SeeedDocument/Wio_GPS_Board/gps_tracker.md

---
title: GPS Tracker
category: Arduino
bzurl:
oldwikiname:
prodimagename: 
surveyurl:
sku:
---



What is GPS Tracker? GPS Tracker is an Arduino compatible development board that helps you to track any moving things on the planet. By integrating GSM&GPRS as well as GPS&BeiDou in one board, it provides an all-in-one solution for your out-door IoT project.

If you are following the latest news about Low-Power Wide-Area Network(LPWAN), you may know that 2016 is a special year because there are new technology like LoRa and Sigfox came out, which remarkably pushed the development of WAN. The GPS Tracker has similarities as LoRa and Sigfox but also quite different. It is more suitable for out-door moving tracking and situations that has high frequency customer interaction and medium volume of data, for example sharing bicycle, logistics location, pet tracking.

Comparing to traditional GPS tracking solution, Seeed’s GPS Tracker is much more easier to use and customize for the fast changing IOT market. As a user-friendly Grove development board, the look of GPS tracker may remind you of Wio Link, another started product of Seeed. So you can also find 6 grove connector on the board. As an Arduino compatible board, users can use the GPS Tracker with Arduino IDE directly.

Why do we call the GPS tracker a solution, because it is really not just a board. At SeeedStudio, we have the ability to help customer customize the GPS tracker for their own project and finish the project all the way to mass production. As GPS tracker uses standard module that is mass production, we are ready to mass production even when customer is at their prototyping stage.

We have prepared everything, the last thing we need is your creative projects, so if you are making an out-door IOT tracking project, please don’t hesitate to use the GPS Tracker!

## Features

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

### Quectel MC20 Module

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

!!!Warning
    Unlike most Arduino & Genuino boards, the GPS Tracker runs at 3.3V. The maximum voltage that the I/O pins can tolerate is 3.3V. Applying voltages higher than 3.3V to any I/O pin could damage the board.

## Specification

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

## Application Ideas

* Intelligent Transportation
* Pet Tracker
* Outdoor sports equipments
* Driving recorder
* Wearable device
* Property Security

!!!Tip
    Use Grove modules to expand your application

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

##Hardware Overview





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

## Pin Map

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

!!!Note
    All pins can act as Digital Input and Output

## Getting Started - Arduino IDE

!!!Note
    This chapter is based on Win10 and Arduino IDE v1.6.0

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

### Install the Driver (For Windows)

When the first time to insert the board, you should get a USB COM device name GPS Tracker that need to install a driver. Click [here](https://github.com/SeeedDocument/Seeeduino_LoRa/raw/master/res/driver.zip) to download driver for the board.

To make sure the driver was installed successful, open your Device Manager to see if **GPS Tracker** exists.

### Install the library of GPS Tracker(For Windows, Linux and Mac)

Click [here](https://github.com/lanselambor/MC20_GPS_Tracker/archive/master.zip) to download the library(zip file) of GPS Tracker and import the zip library into your Arduino IDE. If you are new to this, please click [here](https://www.arduino.cc/en/Guide/Libraries#toc4) for more information.

### Blink

Different from other boards, there is an User LED SK6812 on GPS Tracker, which is an intelligent control LED light source and similar to ws2812b. Now we are going to upload our first demo - Blink to GPS Tracker, which will introduce how to use the User LED.

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

```c
#include "MC20_Arduino_Interface.h"
#include <Adafruit_NeoPixel.h>

#define RGBPIN       10
#define LED_NUM      1

Adafruit_NeoPixel pixels = Adafruit_NeoPixel(LED_NUM, RGBPIN, NEO_GRB + NEO_KHZ800);

void setup() {

  pixels.begin(); // This initializes the NeoPixel library.
}

void loop() {

  // For a set of NeoPixels the first NeoPixel is 0, second is 1, all the way up to the count of pixels minus one.
  // pixels.Color takes RGB values, from 0,0,0 up to 255,255,255
  pixels.setPixelColor(0, pixels.Color(0,0,100)); // Moderately bright blue color.
  pixels.show(); // This sends the updated pixel color to the hardware.
  delay(1000);   // Wait for 1 second
  pixels.setPixelColor(0, pixels.Color(0,0,0));   // Turn off the led.
  pixels.show(); 
  delay(1000); 
}
```

And Then,

* Click on **Tools > Board > GPS Tracker**
* Click on **Tools > Port** to select a right port number. (*Don't choose COM1*)

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

### Check battery

GPS Tracker is designed for tracking moving things outdoor. So you can power the board via a 3.7V Lipo battery with JST1.0 connector and check the voltage of your battery easily.

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

```c
#include "MC20_Arduino_Interface.h"

const int pin_battery_voltage = A4;

void setup() {
    SerialUSB.begin(115200);
}

void loop() {

    int a = analogRead(pin_battery_voltage);
    float v = a/1023.0*3.3*2.0;        // there's an 10M and 10M resistor divider
    SerialUSB.print("The voltage of battery is ");
    SerialUSB.print(v, 2);
    SerialUSB.println(" V");
    delay(1000);
}
```

### Use Grove modules to expand your application

To use 6 Grove connectors on GPS Tracker, we have to use `digitalWrite(12, HIGH)` to open 3V3\_B to power the Grove modules(D12 defaults to LOW in order to reduce consumption).

The following code shows how to use Analog and Digital Grove modules:

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

```c
#include "MC20_Arduino_Interface.h"

#define GrovePowerPin   12
#define LightSensorPin  A0
#define ButtonPin       2

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

void loop() {
    // print analog data when the button is pressed
    if (digitalRead(ButtonPin)) {
        SerialUSB.print("The value of light sensor:");
        SerialUSB.println(analogRead(LightSensorPin));
    }
    delay(500);
}   
```

### GNSS

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

And we have installed a well written library for the GPS Tracker, for simple applications you even don't need to know much about how to use the AT commands, which is complex and hard to read.

The following example shows how to read longitude and latitude and print them out in Serial Monitor. Please note that GPS Tracker should be placed outdoor to get GPS signal.

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

```c
#include "MC20_Common.h"
#include "MC20_Arduino_Interface.h"
#include "MC20_GNSS.h"

GNSS gnss = GNSS();

void setup() {
  SerialUSB.begin(115200);
  // while(!SerialUSB);

  gnss.Power_On();
  SerialUSB.println("\n\rPower On!");

  while(!gnss.open_GNSS()){
    delay(1000);
  }

  SerialUSB.println("Open GNSS OK.");
}

void loop() {
  // gnss.dataFlowMode();
  
  if(gnss.getCoordinate()){
    SerialUSB.print("GNSS: ");
    SerialUSB.print(gnss.longitude, 6); 
    SerialUSB.print(",");
    SerialUSB.println(gnss.latitude, 6);  
  } else{
    SerialUSB.println("Error!");
  }
  
  delay(1000);
}
```

### SMS Message Read

The following example shows how to read sms messages on GPS Tracker. Nano SIM card is needed in this example.

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

 ```c
#include "MC20_Common.h"
#include "MC20_Arduino_Interface.h"

#define RGBPIN 10

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

GPSTracker gpsTracker = GPSTracker();

void setup() {
  // MC20_init();
  pinMode(RGBPIN, OUTPUT);
  digitalWrite(RGBPIN, LOW);
  SerialUSB.begin(115200);
  // while(!SerialUSB);

  gpsTracker.Power_On();
  SerialUSB.println("Power On!");

  // gpsTracker.deleteSMS(1);

}

void loop() {

  if(MC20_check_readable()){
    inComing = 1;
  }else{
    delay(1000);
  }

  if(1 == inComing){
    MC20_read_buffer(buffer, 64);
    SerialUSB.println(buffer);

    if(NULL != (s = strstr(buffer,"+CMTI: \"SM\""))) { //SMS: $$+CMTI: "SM",24$$
        char message[128];
        int messageIndex = atoi(s+12);
        gpsTracker.readSMS(messageIndex, message,128);
        SerialUSB.print("Recv SMS: ");
        SerialUSB.println(message);
     }
     MC20_clean_buffer(buffer,64);  
     inComing = 0;
  }
  
}
 ```

### Bluetooth Connection

It is also very easy to connect to your Bluetooth device on GPS Tracker. Open your Arduino IDE and click on **File > Examples > MC20\_GPS\_Traker > MC20\_BlueTooth > BT\_FastConnect** to open the sketch or copy the blow code.

Then change the deviceName of your Bluetooth device, GPS Tracker will connect it automatically.

```c
#include "MC20_Common.h"
#include "MC20_BT.h"

// GPSTracker gpsTracker = GPSTracker();
BlueTooth bt = BlueTooth();
int bt_state = -1;
char *deviceName = "N-612";

void setup() {
  SerialUSB.begin(115200);
  while(!SerialUSB);

  bt.Power_On();
  SerialUSB.println("\n\rMC20 power On!");
  bt.BTPowerOn();
  SerialUSB.println("\n\rBT power On!");

  while(IDLE != (bt_state = bt.getBTState())){
    SerialUSB.print("State: ");
    SerialUSB.println(bt_state);
    delay(1000);
  }

  bt.BTFastConnect(deviceName, HFG_PROFILE);
}

void loop() {
  /* Debug */
  if(SerialUSB.available()){
    serialMC20.write(SerialUSB.read());
  }
  if(serialMC20.available()){     
    SerialUSB.write(serialMC20.read()); 
  }
}
```

## Resources

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
