SeeedDocument/Wio_GPS_Board/images/insertsim.jpg

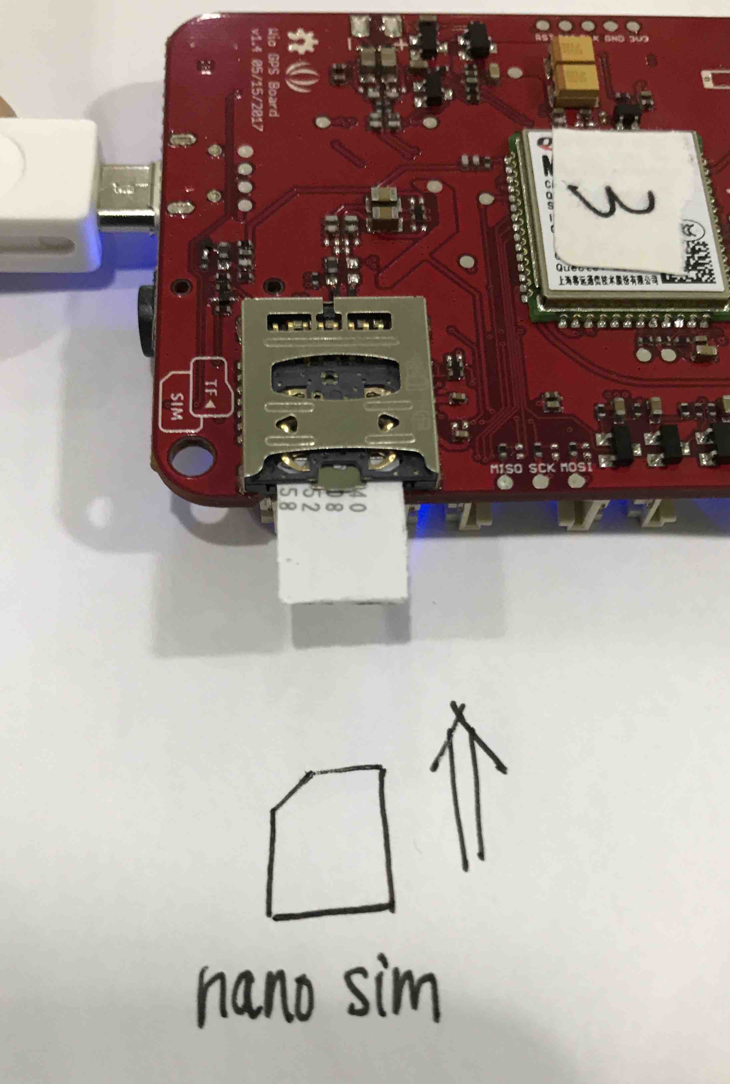
images/insertsim.jpg
