SeeedDocument/Wio_GPS_Board/images/pullsim.jpg

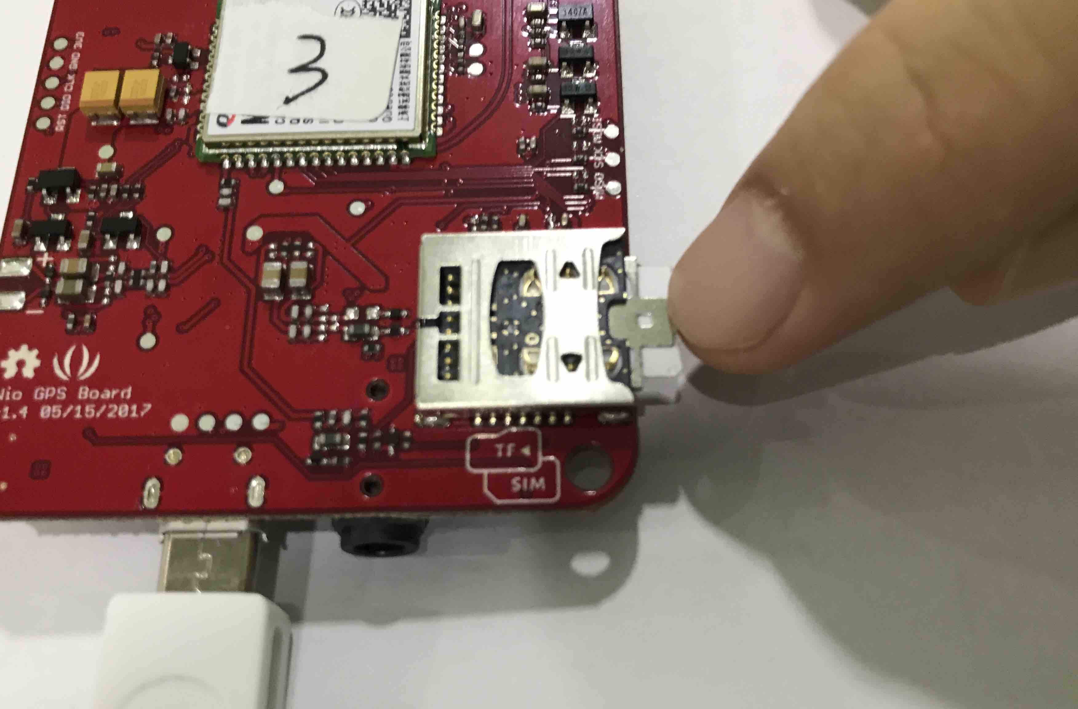
images/pullsim.jpg
