SeeedDocument/Wio_GPS_Board/images/Wio_GPS_Antanna.jpg

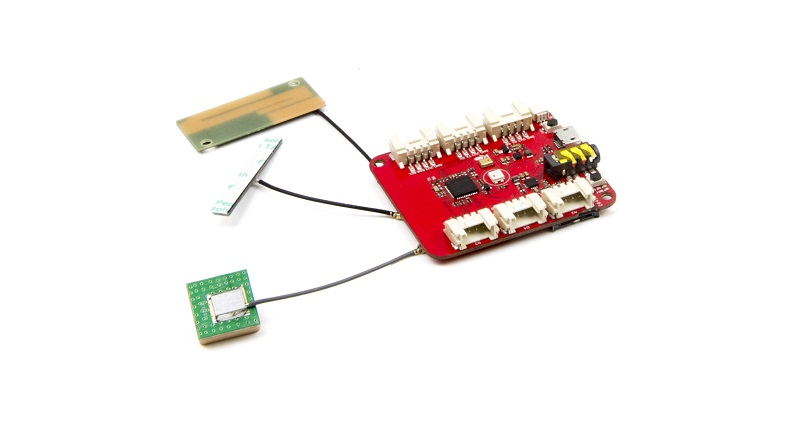
images/Wio_GPS_Antanna.jpg
